team204arm/team204_roboticwheelchairarmproject/Kit Material List.xlsx

Sheet: Kit Cost
Item | Vendor | Part Number | Quantity | Price | Total | Link
Mechanical Components
RoArm-M2-S | Amazon | 795602422700 | 1 | $222.99 | $222.99 | https://www.amazon.com/Expansion-Development-High-Torque-XYGStudy-RoArm-M2-S/dp/B0DMVD3TB7
T-Slotted Framing Rails 8'' | McMaster-Carr | 47065T821 | 1 | $6.93 | $6.93 | https://www.mcmaster.com/47065T821
T-Slotted Framing Rails 5'' | McMaster-Carr | 47065T822 | 1 | $5.53 | $5.53 | https://www.mcmaster.com/47065T822
T-Slotted Framing | McMaster-Carr | 47065T139 | 2 | $6.00 | $12.00 | https://www.mcmaster.com/47065T139
Black Corner Bracket 1'' | McMaster-Carr | 47065T831 | 5 | $9.71 | $48.55 | https://www.mcmaster.com/47065T831/
Zinc-Plated Steel Hex Nut | McMaster-Carr | 90591A250 | 1 | $2.81 | $2.81 | https://www.mcmaster.com/90591A250/
18-8 Stainless Steel Button Head Hex Drive Screws | McMaster-Carr | 97763A814 | 2 | $7.00 | $14.00 | https://www.mcmaster.com/97763A814/
M8x 1.25mm 8mm Lg | McMaster-Carr | 92095A493 | 1 | $6.35 | $6.35 | https://www.mcmaster.com/92095A493/
T Slot Nuts M5 | Amazon | B086MKNYDS | 1 | $8.28 | $8.28 | https://www.amazon.com/Fastener-Nickel-Plated-Sliding-Aluminum-Profile/dp/B086MKNYDS
M5 x 0.8mm 10mm Lg | McMaster-Carr | 92095A208 | 1 | $16.33 | $16.33 | https://www.mcmaster.com/92095A208/
4-Axis Joystick | Amazon | SD082 | 1 | $18.89 | $18.89 | https://www.amazon.com/SaiDian-4-Axis-Joystick-Potentiometer-JH-D400X-R4/dp/B08CGYGMJL/
2-Pack Hose Clamps | Amazon | B0DRHKN6ZK | 1 | $5.94 | $5.94 | https://www.amazon.com/NITRO4X4-Stainless-Steel-Hose-Clamps/dp/B0DRHKN6ZK?s=industrial
WaveShare End Effector Gripper | Amazon | Gripper-A | 1 | $64.99 | $64.99 | https://www.amazon.com/waveshare-High-performance-Closed-loop-Real-time-Protection-Adjustable/dp/B0DY14MXG5
6x12x1/8 Clear Acrylic Sheets | McMaster-Carr | 8560K275 | 2 | $6.95 | $13.90 | https://www.mcmaster.com/8560K275/
3D Print Cost
Custom Prints (Rough Estimate w/shipping + Taxes) | JLC3DP |  | 1 | $870.00 | $870.00 | https://jlc3dp.com/3d-printing-quote
Electronic Components
Adafruit Feather V2 | Adafruit | 5400 | 1 | $19.95 | $19.95 | https://www.adafruit.com/product/5400
Adafruit USB FeatherWing | Adafruit | 5858 | 1 | $14.95 | $14.95 | https://www.adafruit.com/product/5858
DC-DC Power Modules (5 Pack) | Amazon | B0DSZ26LLC | 1 | $8.27 | $8.27 | Amazon.com: hiBCTR 5 Pieces of DC-DC Power Modules for Converting from 12V to 3.3V and 5V, with Multiple Output Voltages of 3.3V, 5V and 12V. : Electronics (https://www.amazon.com/Pieces-Modules-Converting-Multiple-Voltages/dp/B0DSZ26LLC)
XT60 to DC Adapter (2 Pack) | Amazon | B0DHWTZM83 | 1 | $7.99 | $7.99 | https://www.amazon.com/SinLoon-Adapter-Wireless-Soldering-XT-021/dp/B0DHWTZM83
PCB | OSH Park |  | 1 | $48.30 | $48.30 | https://www.bestpcbs.com/blog/2025/06/pcb-board-price-how-much-does-a-pcb-board-cost/
Adafruit Pin header Set | Amazon | B01GQFV13C | 4 | $3.95 | $15.80 | https://www.amazon.com/Adafruit-Short-Feather-Headers-Kit/dp/B01GQFV13C
12 AWG | DigiKey | 1528-1743-ND | 1 | $15.95 | $15.95 | https://www.digikey.com/en/products/detail/adafruit-industries-llc/1311/6198255?gclsrc=aw.ds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
Shargeek 170 Power Bank (Prototype Battery) | Amazon | B0D2VWVPRX | 1 | $101.10 | $101.10 | https://www.amazon.com/SHARGEEK-Portable-Charger-Display-Waterproof/dp/B0D2VWVPRX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
HJGHY 12V 30000mAh Battery (Alt Battery Option) | Amazon | 12V30000MAH-66305718 | 1 | $114.56 | $114.56 | https://www.amazon.com/HJGHY-18000mAH-22000mAh-Rechargeable-Speedboat/dp/B0DWXLDXQJ
4 inch LED screen | Amazon | B0CRGQN58D | 1 | $20.99 | $20.99 | https://www.amazon.com/Hosyond-320x480-Capacitive-Display-Mega2560/dp/B0CRGQN58D
30 Pair 22AWG 2 pin connector Plugs | Amazon | B0B2DC5LGW | 1 | $11.99 | $11.99 | https://www.amazon.com/dp/B0B2DC5LGW?aref=EsVNXBUcu5
10 Pairs 2.0mm 3 Pin Connector Plugs | Amazon | B0DG8VLJF9 | 1 | $8.39 |  | https://www.amazon.com/10Pairs-2-0mm-Female-Connector-Silicone/dp/B0DG8VLJF9?s=electronics
Arcade Buttons | Amazon | LYSB01LXZSV2N-CMPTRACCS | 1 | $11.00 | $11.00 | https://www.amazon.com/EG-STARTS-Illuminated-Joystick-Raspberry/dp/B01LXZSV2N?s=videogames
Round 20mm on-off switches (6 pack) | Amazon | B0F3XLZCDC | 1 | $5.99 | $5.99 | Amazon.com: DWEII 6PCS 12 Volt DC Mini Circle Toggle Switch ON Off Round Rocker Switches SPST 20mm Mini for Car Automotive RV 2 Pin Switch 120V Wired KCD1 : Automotive
Circular Water Resistant USB Extender | Amazon | B0DT4D5L36 | 1 | $11.89 | $11.89 | https://www.amazon.com/dp/B0DT4D5L36
Sleeve Sewing Materials |  |  |  |  | $0.00
Black water proof zipper 8 inch |  | B08YP9Y56T | 2 | $13.99 | $27.98 | https://www.amazon.com/gp/product/B08YP9Y56T?th=1
Black waterproof Nylon, Precut 1-yard |  | B09VXFCV91 | 1 | $11.95 | $11.95 | https://www.amazon.com/gp/product/B09VXFCV91?th=1
50 pack sewing fabric clips |  | B0FHQPS28M | 1 | $13.49 | $13.49 | https://www.amazon.com/gp/product/B0FHQPS28M
Velcro for fabric |  | B0CT2X9Y7W | 1 | $8.49 | $8.49 | https://www.amazon.com/dp/B0CT2X9Y7W
Waterproof thread |  | B0DDTCCWWB | 1 | $11.88 | $11.88 | https://www.amazon.com/Connimonet-Waterproof-1000-Yard-Machines-Stitching/dp/B0DDTCCWWB
Total |  |  |  |  | $1800.01

Sheet: 3D Part Printing Settings
Link: | https://jlc3dp.com/3d-printing-quote?from=button
Part | File Name | 3D Technology/Process | Material | Color | Surface Finish | Product Desc | Cost | QTY | Total Cost
Mount | TubeSystem_mount.STL | FDM | PA12-CF | Black | No |  | $173.21 | 1 | $173.21
Lower tube | TubeSystem_body_Btm_Btry.STL | FDM | PA12-CF | Black | No |  | $103.15 | 1 | $103.15
Upper tube | TubeSystem_body_top_v3.STL | FDM | PA12-CF | Black | No |  | $128.97 | 1 | $128.97
Spacer | TubeSystem_Electronics_4in_v2.STL | FDM | PA12-CF | Black | No |  | $106.47 | 1 | $106.47
Tip | TubeSystem_Tip.STL | FDM | PA12-CF | Black | No |  | $65.05 | 1 | $65.05
Cap |  | SLA | JLC Black Resin | Black | Yes (Genral sanding) |  |  | 2 | $0.00
DC adaptor | DC Jack adaptor | SLA | JLC Black Resin | Black | Yes (Genral sanding) |  | $1.04 | 1 | $1.04
Adaptor nut | DC Jack Nut | SLA | JLC Black Resin | Black | Yes (Genral sanding) |  | $1.04 | 1 | $1.04
Pins | Quick_Swap_Pin.STL | Binder jetting | BJ-316L | N/A | Yes (Polishing) | Stainless Steel Connectors -HS Code 732690 | $11.88 | 2 | $23.76
Rails Left | NewRailsLeftSide.STL | Binder jetting | BJ-316L | N/A | Yes (Polishing) | Stainless Steel Bracket -HS Code 732690 | $12.32 | 1 | $12.32
Rails Right | NewRailsRightSide.STL | Binder jetting | BJ-316L | N/A | Yes (Polishing) | Stainless Steel Bracket -HS Code 732691 | $12.32 | 1 | $12.32
Slide | Quick_Swap_Slide(1).STL | Binder jetting | BJ-316L | N/A | Yes (Polishing) | Stainless Steel Insert Parts -HS Code 732690 | $10.60 | 2 | $21.20
Umbrella Holder | Umbrella_Holder.STL | FDM | PA12-CF | Black | No |  | $18.83 | 1 | $18.83
Bin and Brush | Arm_bracketBinandBrush.STL | FMD | PA12-CF | Black | No |  | $49.38 | 1 | $49.38
Controller Shell | Controller_Shell.STL | FDM | PA12-CF | Black | No |  | $118.54 | 1 | $118.54
Sleeve Bracket | TubeSystem_Bracket.STL | FDM | PA12-CF | Black | No |  | $13.75 | 2 | $27.50
Mounting Cap L | TubeSystem_cap_left. STL | SLS(Nylon) | 3201PA-F Nylon | Black | No |  | $3.12 | 1 | $3.12
Mounting Cap R | TubeSystem_cap_right. STL | SLS(Nylon) | 3201PA-F Nylon | Black | No |  | $3.12 | 1 | $3.12
 |  |  |  |  |  |  |  | TOTAL | $869.02
