team204arm/team204_roboticwheelchairarmproject/Wiring list.pdf

Group | Component | # of wires in group | Color designation | Notes
1 | RoArm | 3 | R: TX | The red wire goes from RX on the RoArm to TX on the PCB
B: GND
Y: RX
2 | Joystick X-axis | 3 | R: VCC
| | | B: GND
| | | Y: A3
3 | Joystick Y-axis | 3 | R: VCC
| | | B: GND
| | | Y: A2
4 | Joystick Z-axis | 3 | R: VCC
| | | B: GND
| | | Y: A4
5 | Joystick Button | 2 | R: A5
| | | B: GND
6 | E-Stop | 2 | R: VCC
| | | B: GND
7 | E-Stop | 2 | R: 14
| | | B: GND
8 | Mode button | 2 | R: 32
| | | B: GND
9 | Screen | 3 | R: VCC | I04 acts as reset
| | | B: GND
| | | Y: I04
10 | Screen | 2 | R: 13
| | | B: 12
11 | Screen | 2 | R: SCK
| | | B: MOSI
