team204arm/team204_roboticwheelchairarmproject/(commit log)

2026-04-23 Rename Menu_Mouse.ino to Mouse_Control.ino
    Current Mouse Control has limited custom function functionality.
2026-06-23 Rename Wrist and Grippers.zip to Wrist and Grippers
2026-06-25 Add files via upload
    Different End-Effector CAD files
2026-06-25 Enhance README with assembly and repository details
    Added sections on assembly, installation, and repository contents to the README.
